bklemencz/ESP_LT8900/README.md

ESP8266 to LT8900 series 2.4G Gateway

MILIGHT remote control command parsing and sending json on MQTT.
If data is not MILIGHT protocol it sends on MQTT as raw buffer.
MQTT command subscribe to send data on 2.4G radio.

Updated HW with more sensors:
https://github.com/bklemencz/RF_24G_Gateway
