bklemencz/ESP_LT8900/HW/v1.1/PDF/ESP_LT8900_Schematic.pdf

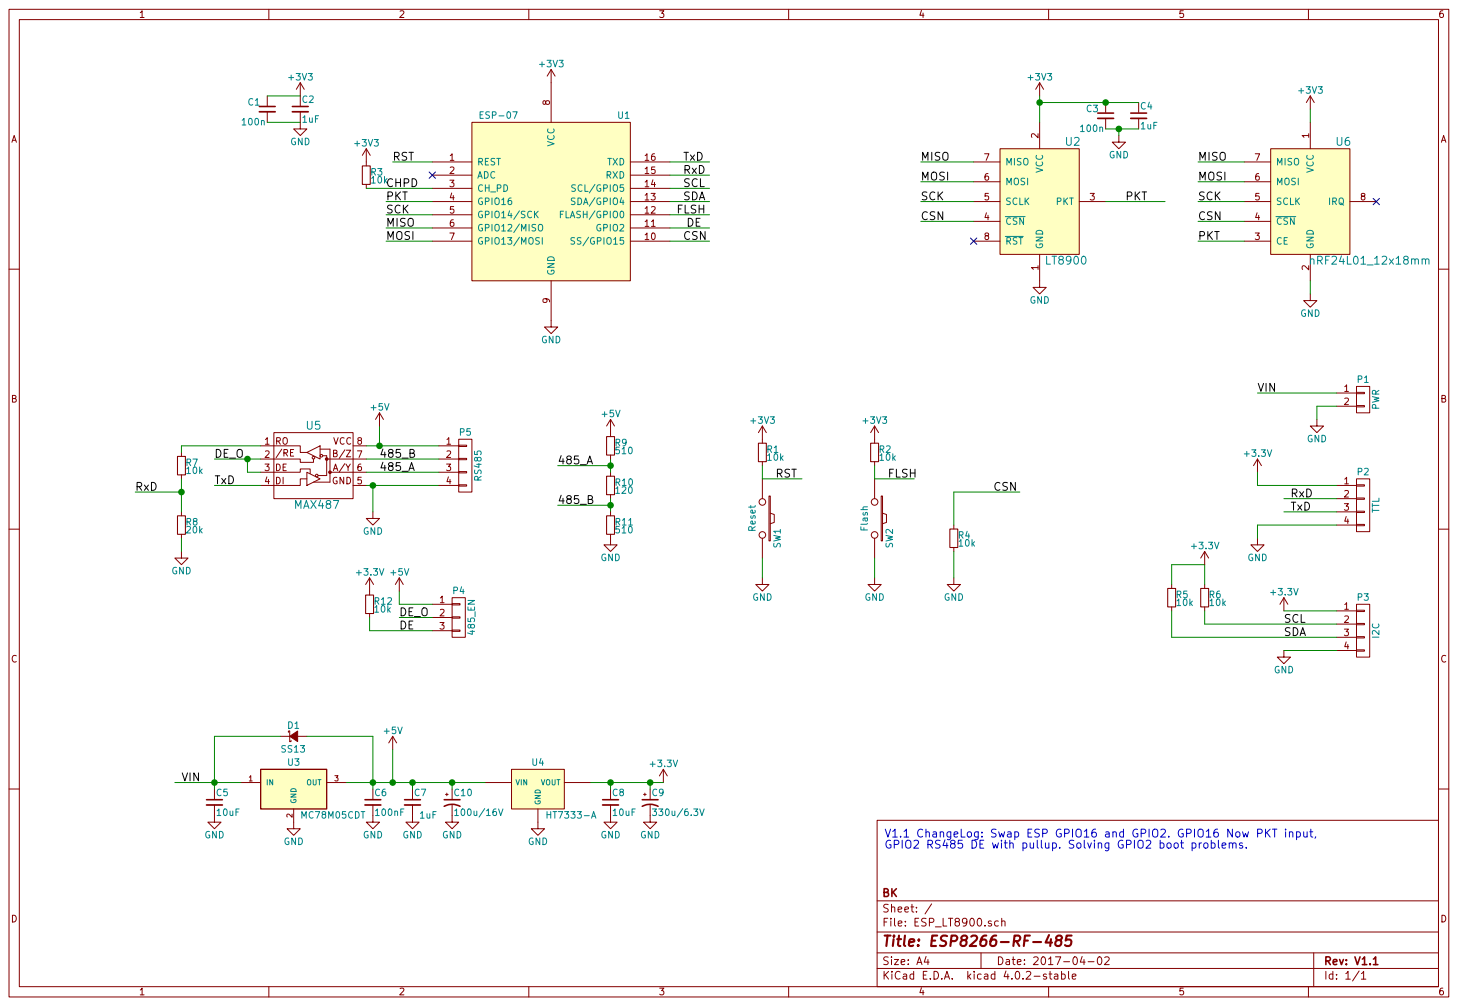
[picture p1: page 1]

9 SS/GPIO15 10 GPIO2 11 FLASH/GPIO0 12 SDA/GPIO4 13 SCL/GPIO5 14 RXD 15 TXD 16 ESP-07 U1 +3V3 GND TxD

2 PKT 3 CSN 4 SCLK 5 MOSI 6 MISO 7 RST 8 U2

2 CE 3 CSN 4 SCLK 5 MOSI 6 MISO 7

GPIO2 RS485 DE with pullup. Solving GPIO2 boot problems.
