bklemencz/ESP_LT8900/HW/v1.1/PDF/ESP_LT8900-B.SilkS.pdf

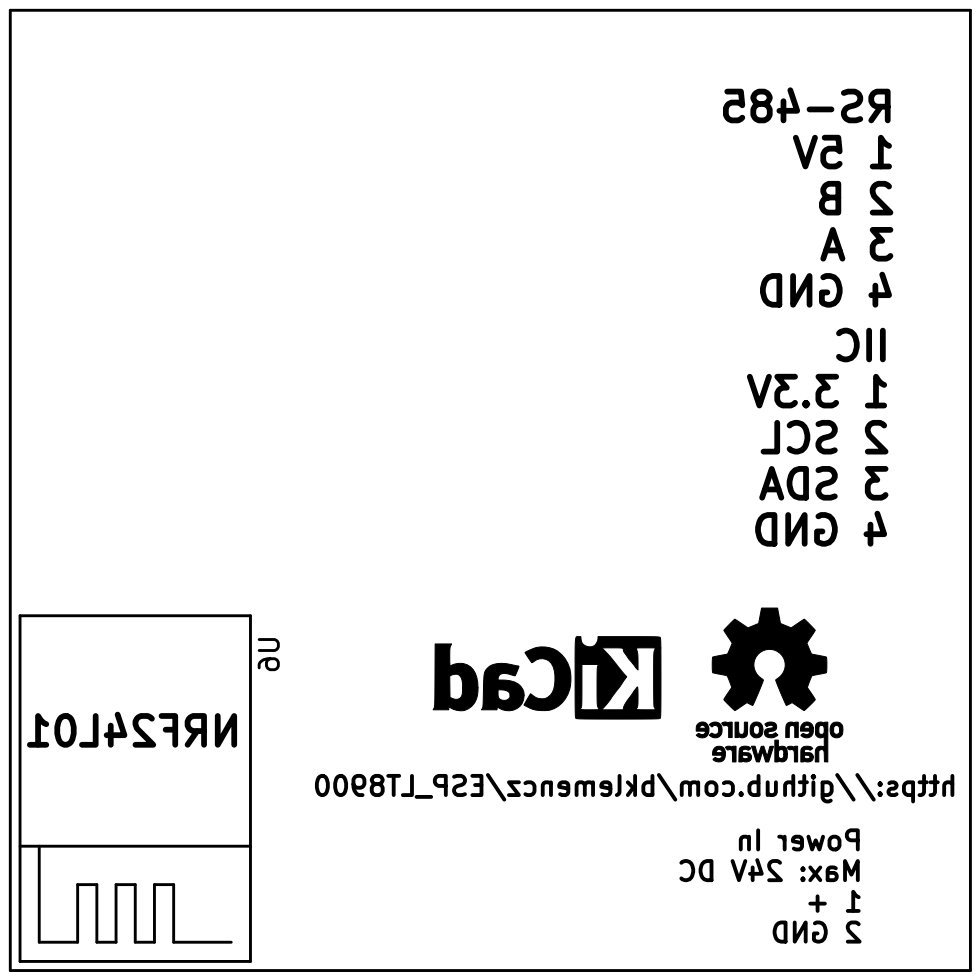
[picture p2: page 1]

https://github.com/bklemencz/ESP_LT8900 NRF24L01 RS-485

Power In Max: 24V DC
