bklemencz/ESP_LT8900/HW/v1.1/PDF/ESP_LT8900-B.Cu.pdf

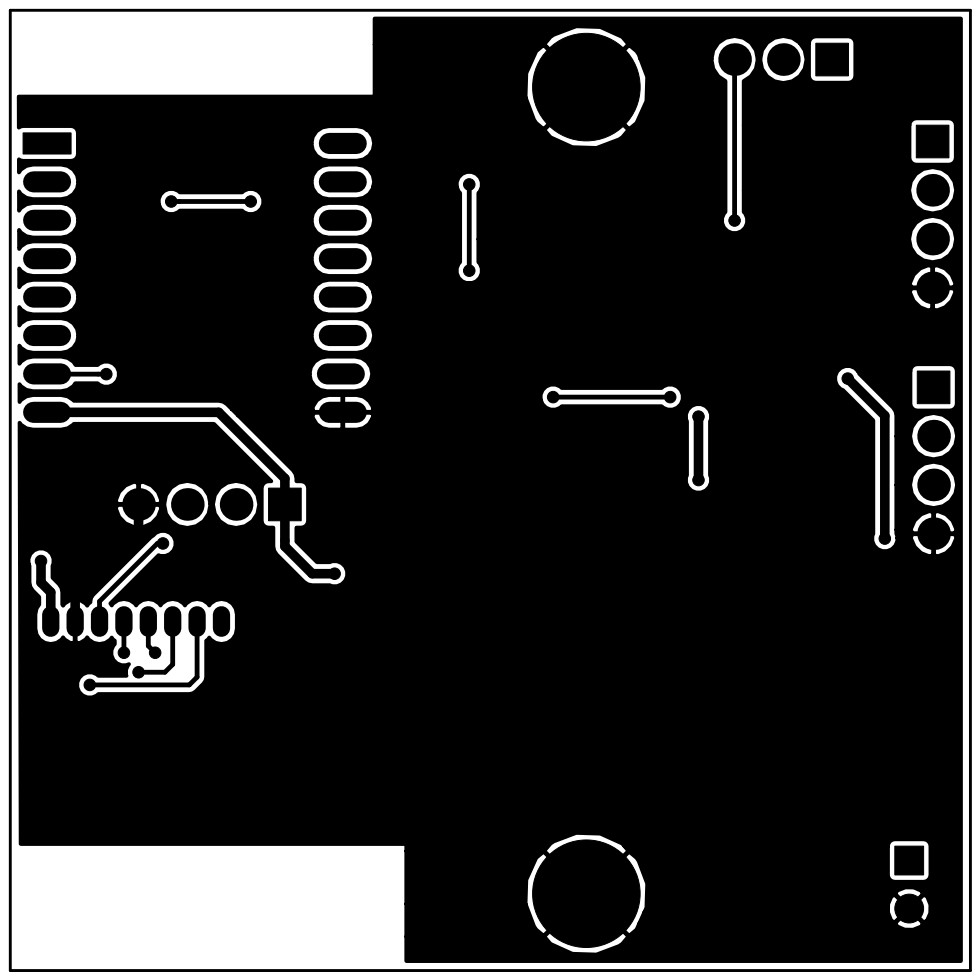
[picture p3: page 1]
