bklemencz/ESP_LT8900/HW/v1.1/PDF/ESP_LT8900-B.Mask.pdf

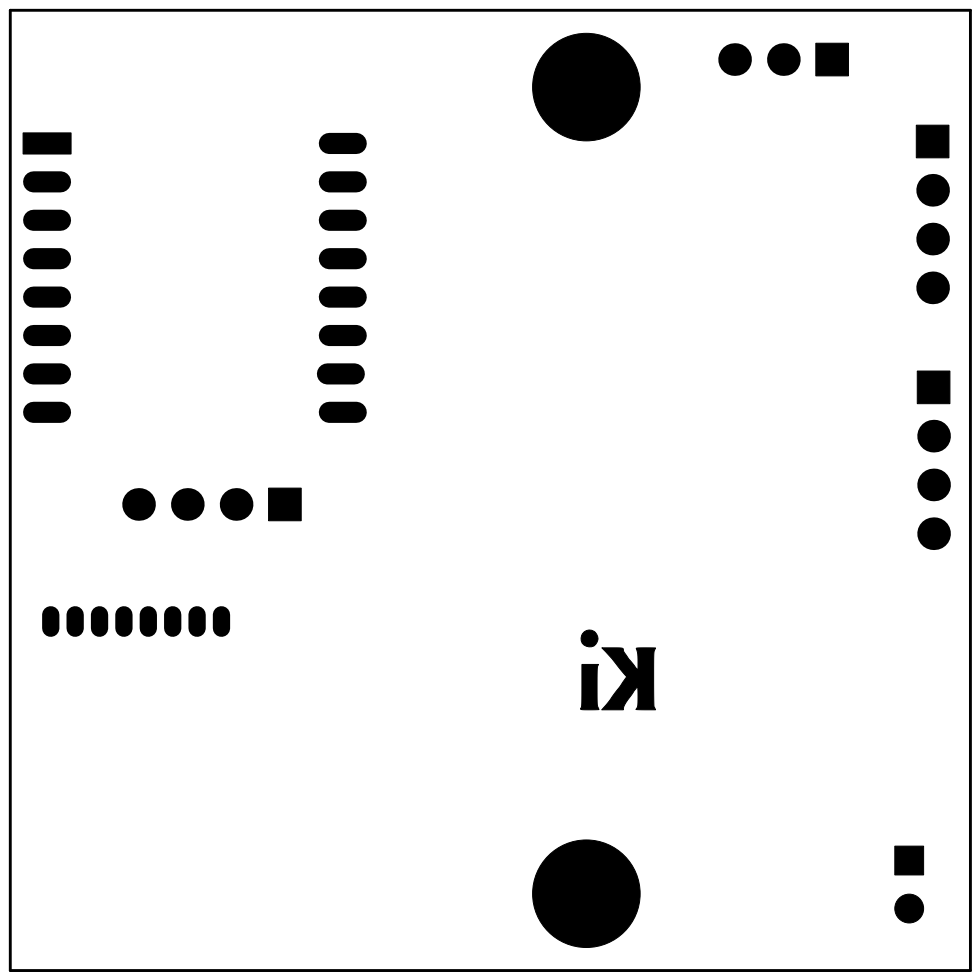
[picture p4: page 1]
