bklemencz/ESP_LT8900/HW/v1.1/PDF/ESP_LT8900-F.Cu.pdf

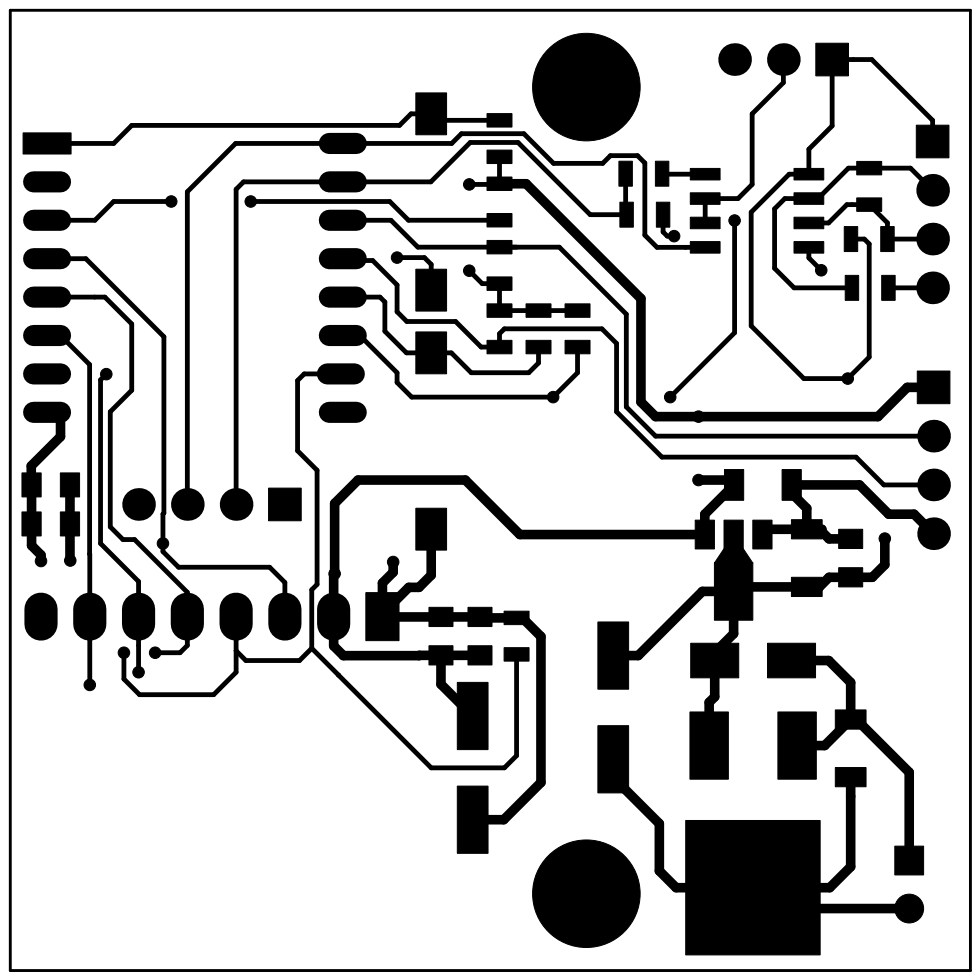
[picture p5: page 1]
