bklemencz/ESP_LT8900/HW/v1.1/PDF/ESP_LT8900-F.Mask.pdf

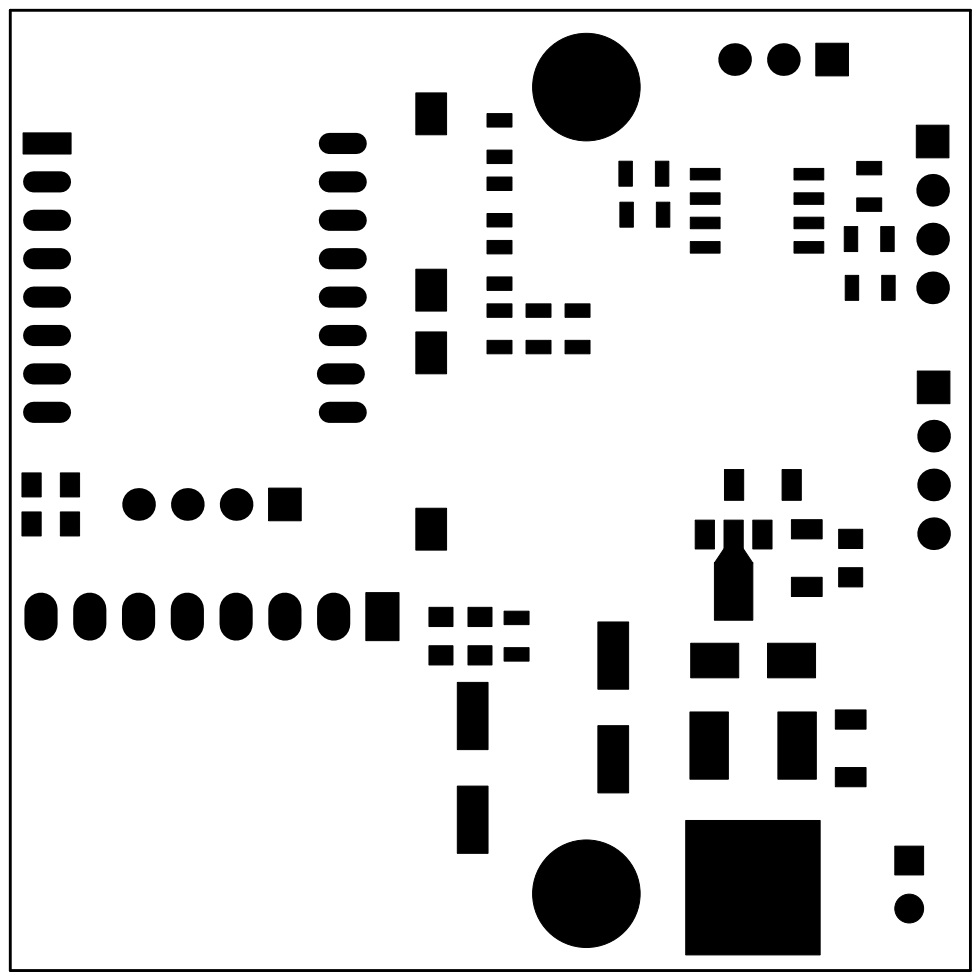
[picture p6: page 1]
