bklemencz/ESP_LT8900/HW/v1.1/PDF/ESP_LT8900-F.SilkS.pdf

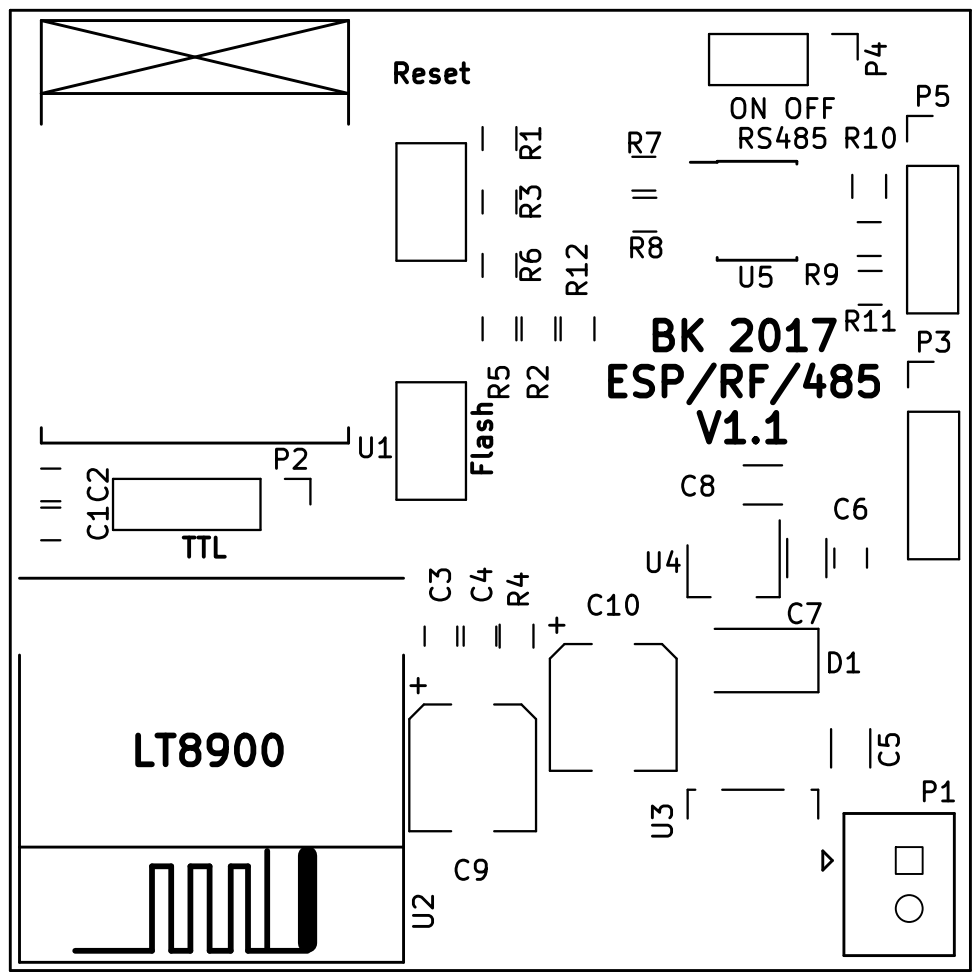
[picture p7: page 1]
