bklemencz/ESP_LT8900/HW/v1.0/PDF/ESP_LT8900-B.SilkS.pdf

https://github.com/bklemencz/ESP_LT8900 NRF24L01 RS-485

Power In Max: 24V DC
