bklemencz/ESP_LT8900/HW/v1.0/PDF/ESP_LT8900-B.Cu.pdf

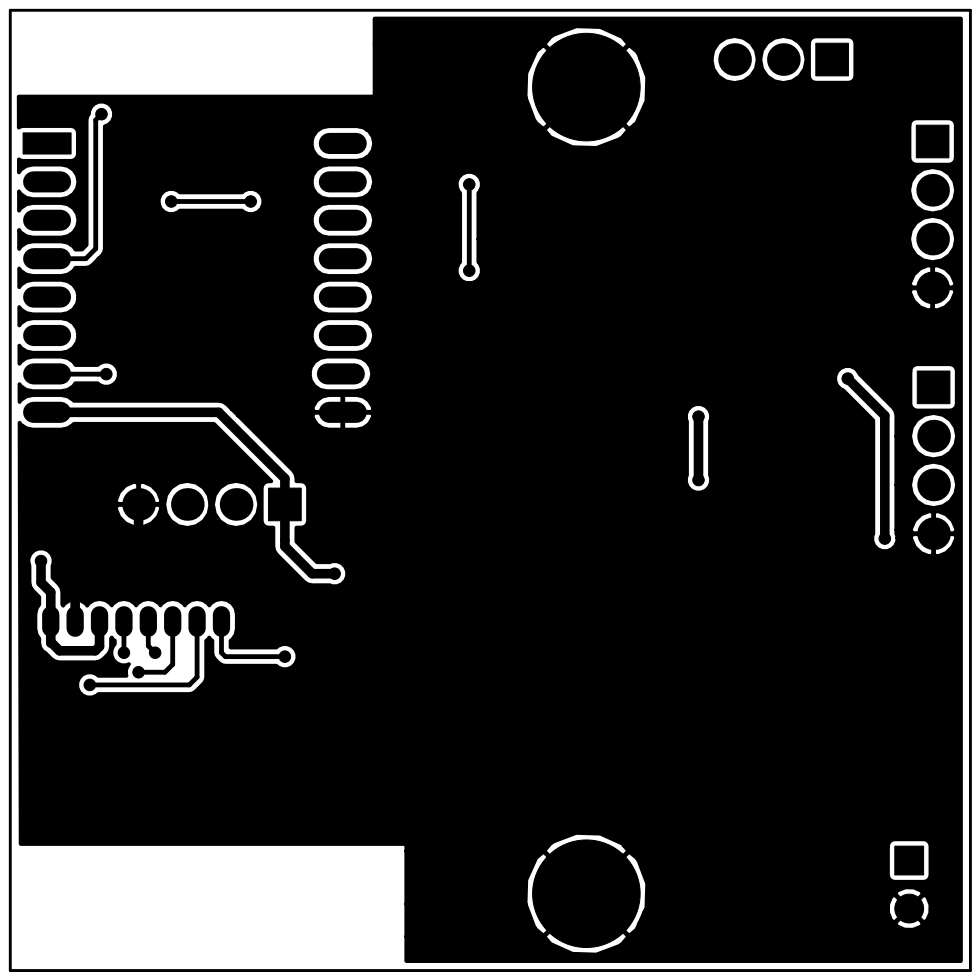
[picture p8: page 1]
