bklemencz/ESP_LT8900/HW/v1.0/PDF/ESP_LT8900-F.Cu.pdf

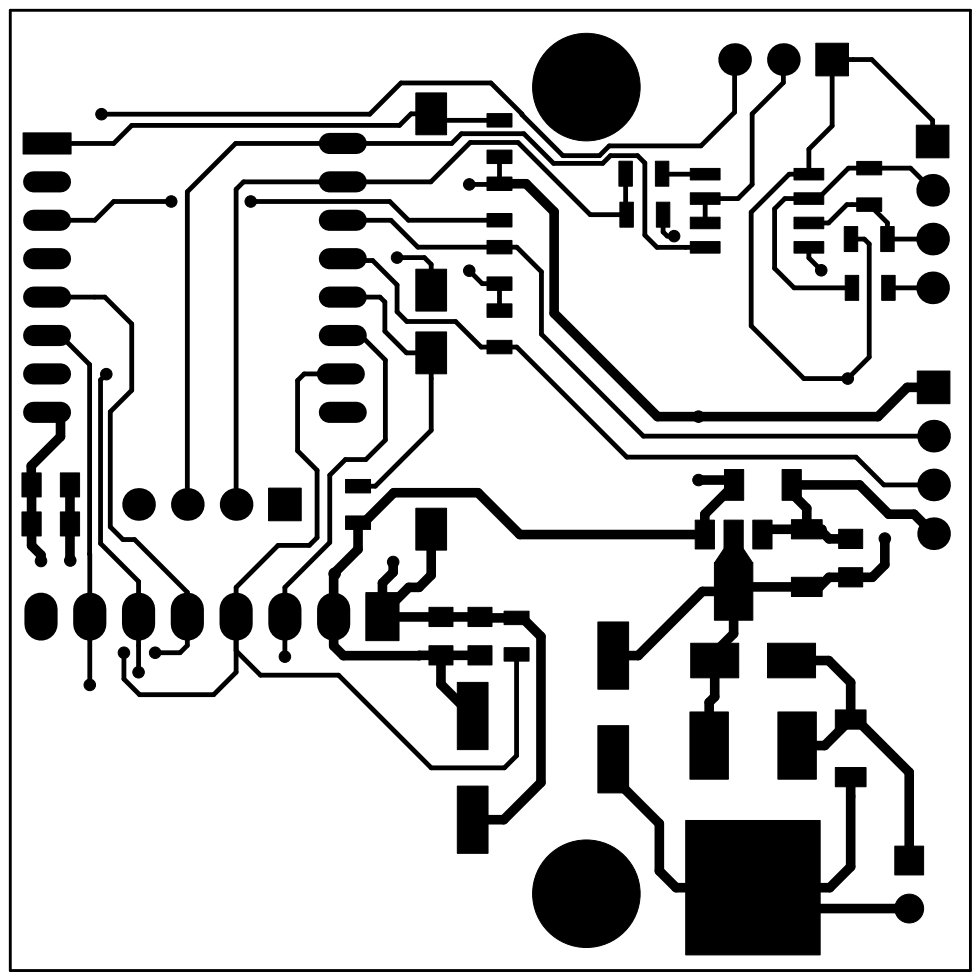
[picture p9: page 1]
