bklemencz/ESP_LT8900/HW/v1.0/PDF/ESP_LT8900-F.Mask.pdf

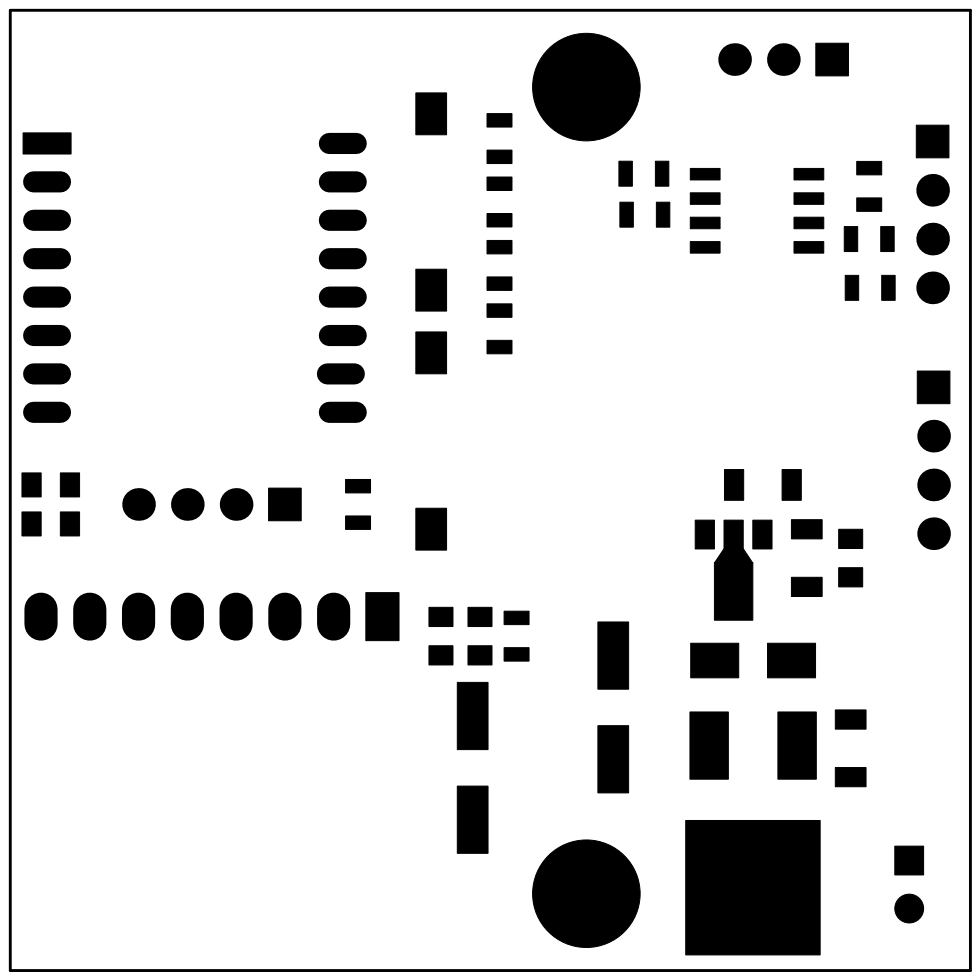
[picture p10: page 1]
