bklemencz/ESP_LT8900/HW/v1.0/PDF/ESP_LT8900-F.SilkS.pdf

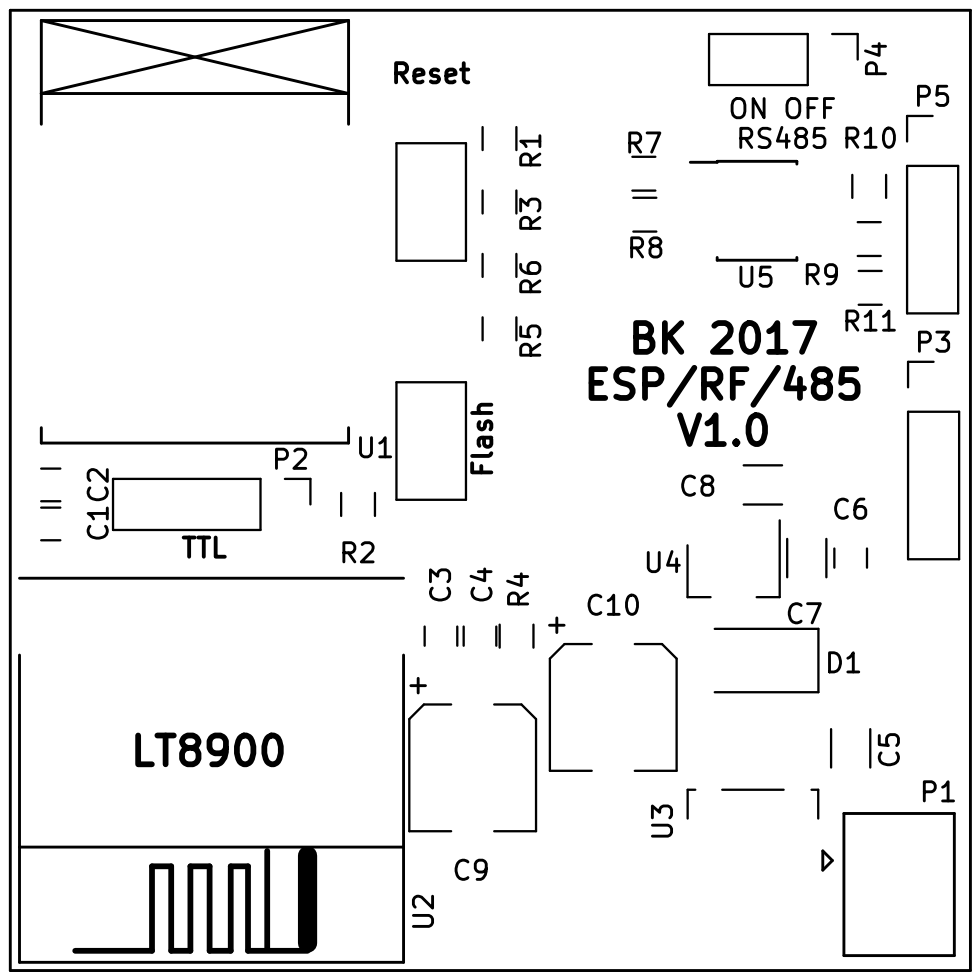
[picture p11: page 1]
