bklemencz/ESP_LT8900/HW/v1.1/ESP_LT8900.kicad_pcb

## KiCad design HW/v1.1/ESP_LT8900.kicad_pcb (2017-06-15)

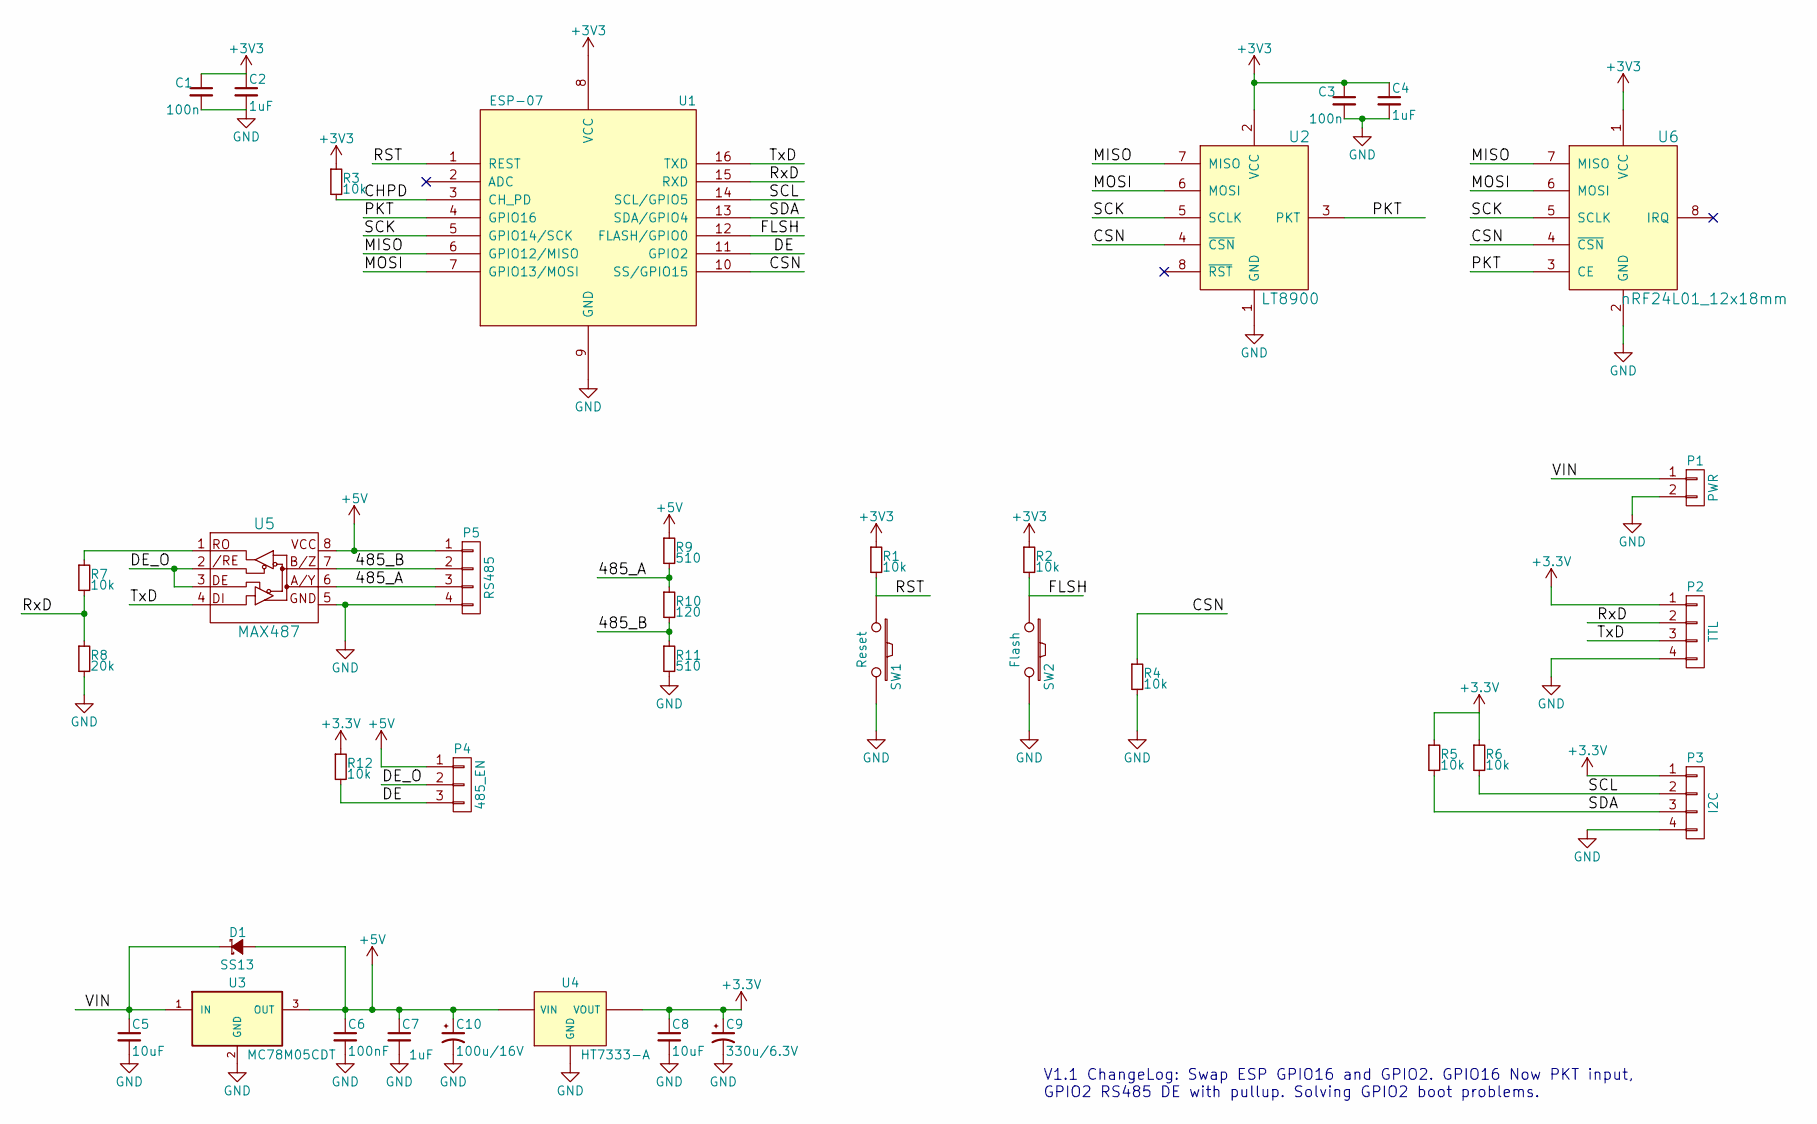
[picture p12: schematic ESP_LT8900.sch, ESP8266-RF-485]

Parts:
C1, C3: 100n; C_0805
C2, C4: 1uF; C_0805
C5, C8: 10uF; C_1206
C6: 100nF; C_0805
C7: 1uF; C_1206
C9: 330u/6.3V; CP_Elec_6.3x7.7
C10: 100u/16V; CP_Elec_6.3x5.3
D1: SS13; D_SMA_Standard
P1: PWR; JST_B2B-XH-A
P2: TTL; Pin_Header_Straight_1x04_Pitch2.54mm
P3: I2C; Pin_Header_Straight_1x04_Pitch2.54mm
P4: 485_EN; Pin_Header_Straight_1x03_Pitch2.54mm
P5: RS485; Pin_Header_Straight_1x04_Pitch2.54mm
R1, R2, R3, R4, R5, R6, R7, R12: 10k; R_0805
R8: 20k; R_0805
R9, R11: 510; R_0805
R10: 120; R_0805
SW1: Reset; SW_SPST_FSMSM
SW2: Flash; SW_SPST_FSMSM
U1: ESP-07; ESP-07v2
U2: LT8900; LT8900_2.54mmPitch_SMD_20x20
U3: MC78M05CDT; TO-252-2Lead
U4: HT7333-A; SOT89-3_Housing
U5: MAX487; SOIC-8_3.9x4.9mm_Pitch1.27mm
U6: nRF24L01_12x18mm; NRF24L01_12x18mm

Connections:
+5V: C6.1, C7.1, C10.1, D1.2 (A), P4.1, P5.1, R9.1, U3.3 (OUT), U4.2 (VIN), U5.8 (VCC)
/485_A: P5.3, R9.2, R10.1, U5.6 (A/Y)
/485_B: P5.2, R10.2, R11.1, U5.7 (B/Z)
/CHPD: R3.2, U1.3 (CH_PD)
/CSN: R4.1, U1.10 (SS/GPIO15), U2.4 (~CSN), U6.4 (~CSN)
/DE: P4.3, R12.2, U1.11 (GPIO2)
/DE_O: P4.2, U5.2 (/RE), U5.3 (DE)
/FLSH: R2.2, SW2.1, U1.12 (FLASH/GPIO0)
/MISO: U1.6 (GPIO12/MISO), U2.7 (MISO), U6.7 (MISO)
/MOSI: U1.7 (GPIO13/MOSI), U2.6 (MOSI), U6.6 (MOSI)
/PKT: U1.4 (GPIO16), U2.3 (PKT), U6.3 (CE)
/RST: R1.2, SW1.1, U1.1 (REST)
/RxD: P2.2, R7.2, R8.1, U1.15 (RXD)
/SCK: U1.5 (GPIO14/SCK), U2.5 (SCLK), U6.5 (SCLK)
/SCL: P3.2, R6.2, U1.14 (SCL/GPIO5)
/SDA: P3.3, R5.2, U1.13 (SDA/GPIO4)
/TxD: P2.3, U1.16 (TXD), U5.4 (DI)
/VIN: C5.1, D1.1 (K), P1.1, U3.1 (IN)
GND: C1.2, C2.2, C3.2, C4.2, C5.2, C6.2, C7.2, C8.2, C9.2, C10.2, P1.2, P2.4, P3.4, P5.4, R4.2, R8.2, R11.2, SW1.2, SW2.2, U1.9 (GND), U2.1 (GND), U3.2 (GND), U4.1 (GND), U5.5 (GND), U6.2 (GND); also elsewhere on the board
unnamed: R7.1, U5.1 (RO)

Notes on the sheet:
V1.1 ChangeLog: Swap ESP GPIO16 and GPIO2. GPIO16 Now PKT input, GPIO2 RS485 DE with pullup. Solving GPIO2 boot problems.

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
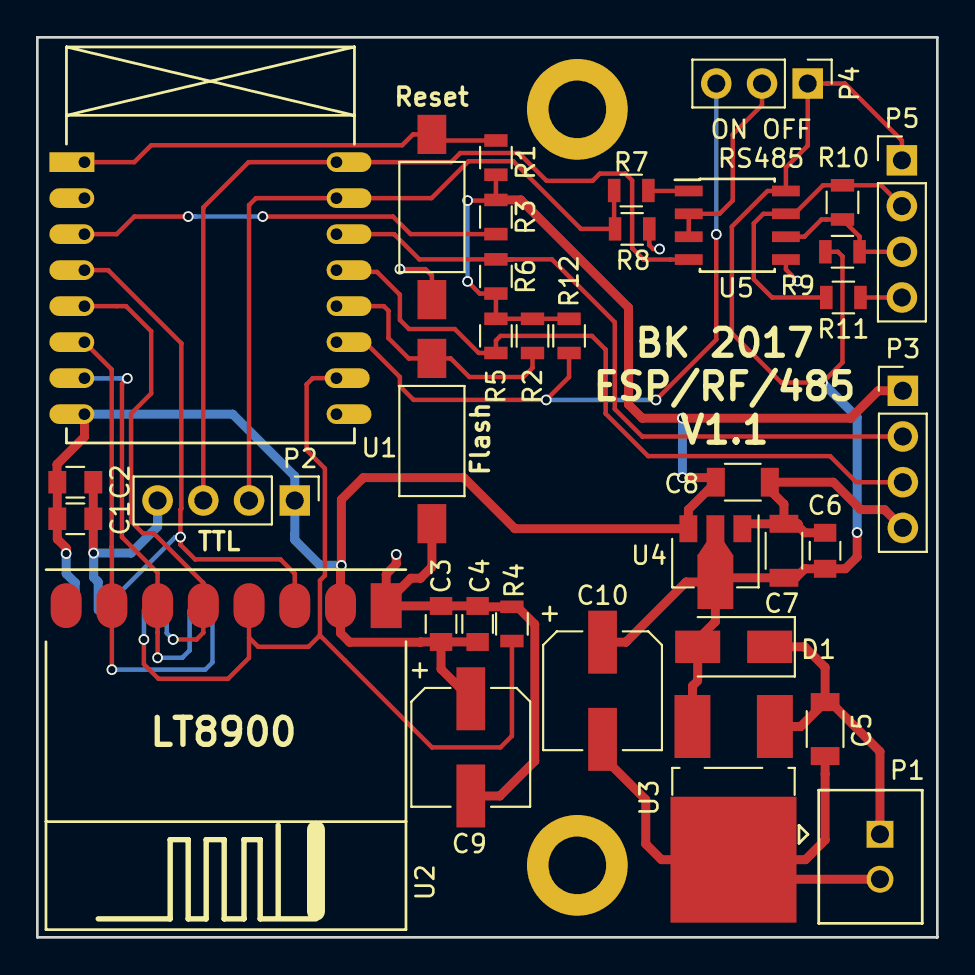
[picture p13: board ESP_LT8900.kicad_pcb from above]

Board: 2 copper layers, 50.0 x 50.0 mm, 38 parts (1 on the bottom side), 21 nets.

Other parts of the board:
M1, M2: MountingHole_3.2mm_M3_DIN965_Pad

Their connections:
GND: M1.1, M2.1; also elsewhere on the board
