bklemencz/ESP_LT8900/SW/src/LT8900.cpp

/*
 Copyright (C) 2015 Rob van der Veer, <rob.c.veer@gmail.com>

 This program is free software; you can redistribute it and/or
 modify it under the terms of the GNU General Public License
 version 2 as published by the Free Software Foundation.
 */

 /*
 6/12/2017 Update BK
 RST and PKT pins can be set to 0
 When PKT set to 0 available() is polling Register 48 PKT_FLAG,
 same for SendPacket() routine.
 Moved #definitions to the include file.
 */

#include <SPI.h>
#include "LT8900.h"



// if RST pin not used set to 0
// if PKT pin not used set to 0

LT8900::LT8900(const uint8_t cs, const uint8_t pkt, const uint8_t rst)
{
  _pin_chipselect = cs;
  _pin_pktflag = pkt;
  _pin_reset = rst;
  _channel = DEFAULT_CHANNEL;
  _isLT8910 = false;

  pinMode(_pin_chipselect, OUTPUT);
  // Added checks if pins disabled.
  if (_pin_pktflag>0) pinMode(_pin_pktflag, INPUT);
  if (_pin_reset >0) pinMode(_pin_reset, OUTPUT);

  digitalWrite(_pin_chipselect, HIGH);
}

void LT8900::begin()
{
    // Added check if PIN is enabled
    if(_pin_reset > 0)
    {
        digitalWrite(_pin_reset, LOW);
        delay(200);
        digitalWrite(_pin_reset, HIGH);
        delay(200);
    }
  //setup

  writeRegister(0, 0x6fe0);
  writeRegister(1, 0x5681);
  writeRegister(2, 0x6617);
  writeRegister(4, 0x9cc9);    //why does this differ from powerup (5447)
  writeRegister(5, 0x6637);    //why does this differ from powerup (f000)
  writeRegister(7, 0x004c);    //ch76
  writeRegister(8, 0x6c90);    //power (default 71af) UNDOCUMENTED
  writeRegister(9, 0x4800);
  //setCurrentControl(4, 0);     // power & gain.

  writeRegister(10, 0x7ffd);   //bit 0: XTAL OSC enable
  writeRegister(11, 0x0008);   //bit 8: Power down RSSI (0=  RSSI operates normal)
  writeRegister(12, 0x0000);
  writeRegister(13, 0x48bd);   //(default 4855)

  writeRegister(22, 0x00ff);
  writeRegister(23, 0x8005);  //bit 2: Calibrate VCO before each Rx/Tx enable
  writeRegister(24, 0x0067);
  writeRegister(25, 0x1659);
  writeRegister(26, 0x19e0);
  writeRegister(27, 0x1300);  //bits 5:0, Crystal Frequency adjust
  writeRegister(28, 0x1800);

  //fedcba9876543210
  writeRegister(32, 0x4800);  //AAABBCCCDDEEFFFG  A preamble length, B, syncword length, c trailer length, d packet type
  //                  E FEC_type, F BRCLK_SEL, G reserved
  //0x5000 = 0101 0000 0000 0000 = preamble 010 (3 bytes), B 10 (48 bits)

  writeRegister(33, 0x3fc7);
  writeRegister(34, 0x2000);  //
  writeRegister(35, 0x0300);  //POWER mode,  bit 8/9 on = retransmit = 3x (default)

  //setSyncWord(0x03805a5a03800380);
    writeRegister(36, 0x050A);
    writeRegister(37, 0x0000);
    writeRegister(38, 0x0000);
    writeRegister(39, 0x55AA);

  writeRegister(40, 0x4402);  //max allowed error bits = 0 (01 = 0 error bits)
  writeRegister(41, 0xB000);
 // writeRegister(R_PACKETCONFIG,PACKETCONFIG_CRC_ON | PACKETCONFIG_PACK_LEN_ENABLE | PACKETCONFIG_FW_TERM_TX);

  writeRegister(42, 0xfdb0);
  writeRegister(43, 0x000f);

  //check the variant.
  _isLT8910 = setDataRate(LT8910_62KBPS);
  //return to defaults.
  setDataRate(LT8900_1MBPS);

  //15:8, 01: 1Mbps 04: 250Kbps 08: 125Kbps 10: 62.5Kbps

  writeRegister(R_FIFO, 0x0000);  //TXRX_FIFO_REG (FIFO queue)

  writeRegister(R_FIFO_CONTROL, 0x8080); //Fifo Rx/Tx queue reset

  delay(200);
  writeRegister(R_CHANNEL, _BV(CHANNEL_TX_BIT));  //set TX mode.  (TX = bit 8, RX = bit 7, so RX would be 0x0080)
  delay(2);
  writeRegister(R_CHANNEL, 0x30);  // Frequency = 2402 + channel
}

void LT8900::softReset()
{
  uint16_t status = readRegister(R_POWER_MODE);
  writeRegister(R_POWER_MODE,status | POWER_DOWN_ENABLE);
  delay(50);
  writeRegister(R_POWER_MODE,status & POWER_DOWN_DISABLE);
}

void LT8900::setChannel(uint8_t channel)
{
  _channel = channel;
  writeRegister(R_CHANNEL,  (_channel & CHANNEL_MASK));
}

uint8_t LT8900::getChannel()
{
  return _channel;
}

bool LT8900::getIs8910()
{
  return _isLT8910;
}

void LT8900::setCurrentControl(uint8_t power, uint8_t gain)
{
  writeRegister(R_CURRENT,
                ((power << CURRENT_POWER_SHIFT) & CURRENT_POWER_MASK) |
                ((gain << CURRENT_GAIN_SHIFT) & CURRENT_GAIN_MASK));
}

bool LT8900::setDataRate(DataRate rate)
{
  uint16_t newValue;

  switch (rate)
  {
    case LT8900_1MBPS:
      newValue = DATARATE_1MBPS;
      break;
    case LT8910_250KBPS:
      newValue = DATARATE_250KBPS;
      break;
    case LT8910_125KBPS:
      newValue = DATARATE_125KBPS;
      break;
    case LT8910_62KBPS:
      newValue = DATARATE_62KBPS;
      break;
    default:
      return false;
  }

  writeRegister(R_DATARATE, newValue);

  //verify
  return (readRegister(R_DATARATE) == newValue);
}

LT8900::DataRate LT8900::getDataRate()
{
  uint16_t value = readRegister(R_DATARATE) & DATARATE_MASK;
  switch (value)
  {
    case DATARATE_1MBPS:
      return LT8900_1MBPS;
    case DATARATE_250KBPS:
      return LT8910_250KBPS;
    case DATARATE_125KBPS:
      return LT8910_125KBPS;
    case DATARATE_62KBPS:
      return LT8910_62KBPS;
  }
}

uint16_t LT8900::readRegister(uint8_t reg)
{
  digitalWrite(_pin_chipselect, LOW);
  SPI.transfer(REGISTER_READ | (REGISTER_MASK & reg));
  uint8_t high = SPI.transfer(0x00);
  uint8_t low = SPI.transfer(0x00);

  digitalWrite(_pin_chipselect, HIGH);

  // Serial.print(reg);
  // Serial.print(" = ");
  // Serial.println(high << 8 | low);

  return (high << 8 | low);
}

uint8_t LT8900::writeRegister(uint8_t reg, uint16_t data)
{
  uint8_t high = data >> 8;
  uint8_t low = data & 0xFF;

  return writeRegister2(reg, high, low);
}

uint8_t LT8900::writeRegister2(uint8_t reg, uint8_t high, uint8_t low)
{

  // char sbuf[32];
  // sprintf_P(sbuf, PSTR("%d => %02x%02x"), reg, high, low);
  // Serial.println(sbuf);


  digitalWrite(_pin_chipselect, LOW);

  uint8_t result = SPI.transfer(REGISTER_WRITE | (REGISTER_MASK & reg));
  SPI.transfer(high);
  SPI.transfer(low);

  digitalWrite(_pin_chipselect, HIGH);
  return result;
}

void LT8900::sleep()
{
  //set bit 14 on register 35.
  writeRegister(35, readRegister(35) | _BV(14));
}

void LT8900::whatsUp(Stream &stream)
{
  uint16_t mode = readRegister(R_CHANNEL);
  stream.print("\nTx_EN=");
  stream.println((mode & _BV(CHANNEL_TX_BIT)) != false);
  stream.print("Rx_En=");
  stream.println((mode & _BV(CHANNEL_RX_BIT)) != false);
  stream.print("Channel=");
  stream.println(mode & CHANNEL_MASK);

  //read the status register.
  uint16_t state = readRegister(R_STATUS);

  bool crc_error = state & _BV(15);
  bool fec23_error = state & _BV(14);
  uint8_t framer_st = (state & 0b0011111100000000) >> 8;
  bool pkt_flag = state & _BV(6);
  bool fifo_flag = state & _BV(5);

  stream.print("CRC=");
  stream.println(crc_error);
  stream.print("FEC=");
  stream.println(fec23_error);
  stream.print("FRAMER_ST=");
  stream.println(framer_st);
  stream.print("PKT=");
  stream.println(pkt_flag);
  stream.print("FIFO=");
  stream.println(fifo_flag);

  uint16_t fifo = readRegister(R_FIFO_CONTROL);
  stream.print("FIFO_WR_PTR=");
  stream.println((fifo >> 8) & 0b111111);
  stream.print("FIFO_RD_PTR=");
  stream.println(fifo & 0b111111);
}

bool LT8900::available()
{
  //read the PKT_FLAG state; this can also be done with a hard wire.

  if ((_pin_pktflag>0) && (digitalRead(_pin_pktflag) != 0))
  {
    return true;
  }
  if (_pin_pktflag==0)
  {
    uint16_t value = readRegister(R_STATUS);
    if (bitRead(value,STATUS_PKT_FLAG))
    {
        return true;
    }
  }
  return false;
}

int LT8900::read(uint8_t *buffer, size_t maxBuffer)
{
  uint16_t value = readRegister(R_STATUS);
  uint16_t data = readRegister(R_FIFO);
  if (bitRead(value, STATUS_CRC_BIT) == 0)
  {
    //CRC ok

    
    uint8_t packetSize = data >> 8;
    if(maxBuffer < packetSize+1)
    {
        //BUFFER TOO SMALL
        return -2;
    }

    uint8_t pos;
    buffer[pos++] = (data & 0xFF);
    while (pos < packetSize)
    {
      data = readRegister(R_FIFO);
      buffer[pos++] = data >> 8;
      buffer[pos++] = data & 0xFF;
    }

    return packetSize;
  }
  else
  {
    //CRC error
    return -1;
  }
}

void LT8900::startListening()
{

  if (_pin_pktflag >0) pinMode(_pin_pktflag, INPUT);
  writeRegister(R_CHANNEL, _channel & CHANNEL_MASK);   //turn off rx/tx
  delay(1);
  writeRegister(R_FIFO_CONTROL, 0x0080);  //flush rx
  delay(1);
  writeRegister(R_CHANNEL,  (_channel & CHANNEL_MASK) | _BV(CHANNEL_RX_BIT));   //enable RX
}

/* set the BRCLK_SEL value */
void LT8900::setClock(uint8_t clock)
{
  //register 32, bits 3:1.
  uint16_t val = readRegister(35);
  val &= 0b1111111111110001;
  val |= ((clock & 0x07) << 1);;

  writeRegister(35, val);
}

bool LT8900::sendPacket(uint8_t *data, size_t packetSize)
{
  if (packetSize < 1 || packetSize > 255)
  {
    return false;
  }

  writeRegister(R_CHANNEL, 0x0000);
  writeRegister(R_FIFO_CONTROL, 0x8000);  //flush tx

  //packets are sent in 16bit words, and the first word will be the packet size.
  //start spitting out words until we are done.

  uint8_t pos = 0;
  writeRegister2(R_FIFO, packetSize, data[pos++]);
  while (pos < packetSize)
  {
    uint8_t msb = data[pos++];
    uint8_t lsb = data[pos++];

    writeRegister2(R_FIFO, msb, lsb);
  }

  writeRegister(R_CHANNEL,  (_channel & CHANNEL_MASK) | _BV(CHANNEL_TX_BIT));   //enable RX

  //Wait until the packet is sent.
  if (_pin_pktflag > 0)
  {
    while (digitalRead(_pin_pktflag) == 0)
    {
        //do nothing.
    }
  } else
  {
    uint16_t value = readRegister(R_STATUS);
    while (bitRead(value,STATUS_PKT_FLAG)==0)
    {
      value = readRegister(R_STATUS);
    }
  }
  return true;
}

void LT8900::setSyncWord(uint64_t syncWord)
{
  writeRegister(R_SYNCWORD1, syncWord);
  writeRegister(R_SYNCWORD2, syncWord >> 16);
  writeRegister(R_SYNCWORD3, syncWord >> 32);
  writeRegister(R_SYNCWORD4, syncWord >> 48);
}

void LT8900::setSyncWordLength(uint8_t option)
{
  option &= 0x03;
  option <<= 11;

  writeRegister(32, (readRegister(32) & 0b0001100000000000) | option);
}

uint8_t LT8900::getRSSI()
{
    //RSSI: 15:10
    uint16_t value = readRegister(6);

    return (value >> 10);
}

void LT8900::scanRSSI(uint16_t *buffer, uint8_t start_channel, uint8_t num_channels)
{
    // writeRegister(R_CHANNEL, _BV(CHANNEL_RX_BIT));
    //
    // //add read mode.
    writeRegister(R_FIFO_CONTROL, 0x8080);  //flush rx
    // writeRegister(R_CHANNEL, 0x0000);

    //set number of channels to scan.
    writeRegister(42, (readRegister(42) & 0b0000001111111111) | ((num_channels-1 & 0b111111) << 10));

    //set channel scan offset.
    writeRegister(43, (readRegister(43) & 0b0000000011111111) | ((start_channel & 0b1111111) << 8));
    writeRegister(43, (readRegister(43) & 0b0111111111111111) | _BV(15));

    if (_pin_pktflag > 0)
    {
      while (digitalRead(_pin_pktflag) == 0)
      {
          //do nothing.
      }
    } else
    {
      uint16_t value = readRegister(R_STATUS);
      while (bitRead(value,STATUS_PKT_FLAG)==0)
      {
        value = readRegister(R_STATUS);
      }
    }


    //read the results.
     uint8_t pos = 0;
    while(pos < num_channels)
    {
      uint16_t data = readRegister(R_FIFO);
      buffer[pos++] = data >> 8;
    }
}
