bklemencz/ESP_LT8900/(commit log)

2017-05-30 HW &SW Folder Update
    [ESP_LT8900-B.Cu.gbl, ESP_LT8900-B.Mask.gbs, ESP_LT8900-B.SilkS.gbo, ESP_LT8900-Edge.Cuts.gm1, ESP_LT8900-F.Cu.gtl, ESP_LT8900-F.Mask.gts, ESP_LT8900-F.SilkS.gto, ESP_LT8900-drl_map.gbr]
2017-05-30 PDF Folder
    [ESP_LT8900.kicad_pcb]
2017-06-12 LT8900 Update
    Use without PKT pin
2017-06-14 HW v1.0 folder
    [ESP_LT8900-B.Cu.gbl, ESP_LT8900-B.Mask.gbs, ESP_LT8900-B.SilkS.gbo, ESP_LT8900-Edge.Cuts.gm1, ESP_LT8900-F.Cu.gtl, ESP_LT8900-F.Mask.gts, ESP_LT8900-F.SilkS.gto, ESP_LT8900-drl_map.gbr]
2017-06-15 HW v1.1
    Swap ESP GPIO16 and GPIO2. Pullup on GPIO2.
    [ESP_LT8900-B.Cu.gbl, ESP_LT8900-B.Mask.gbs, ESP_LT8900-B.SilkS.gbo, ESP_LT8900-Edge.Cuts.gm1, ESP_LT8900-F.Cu.gtl, ESP_LT8900-F.Mask.gts, ESP_LT8900-F.SilkS.gto, ESP_LT8900-drl_map.gbr]
2017-07-04 Baro Sensor Upd
